sidianneng/batteryless_remote/doc/no_battery_ir_ctl-schematic-v04.pdf

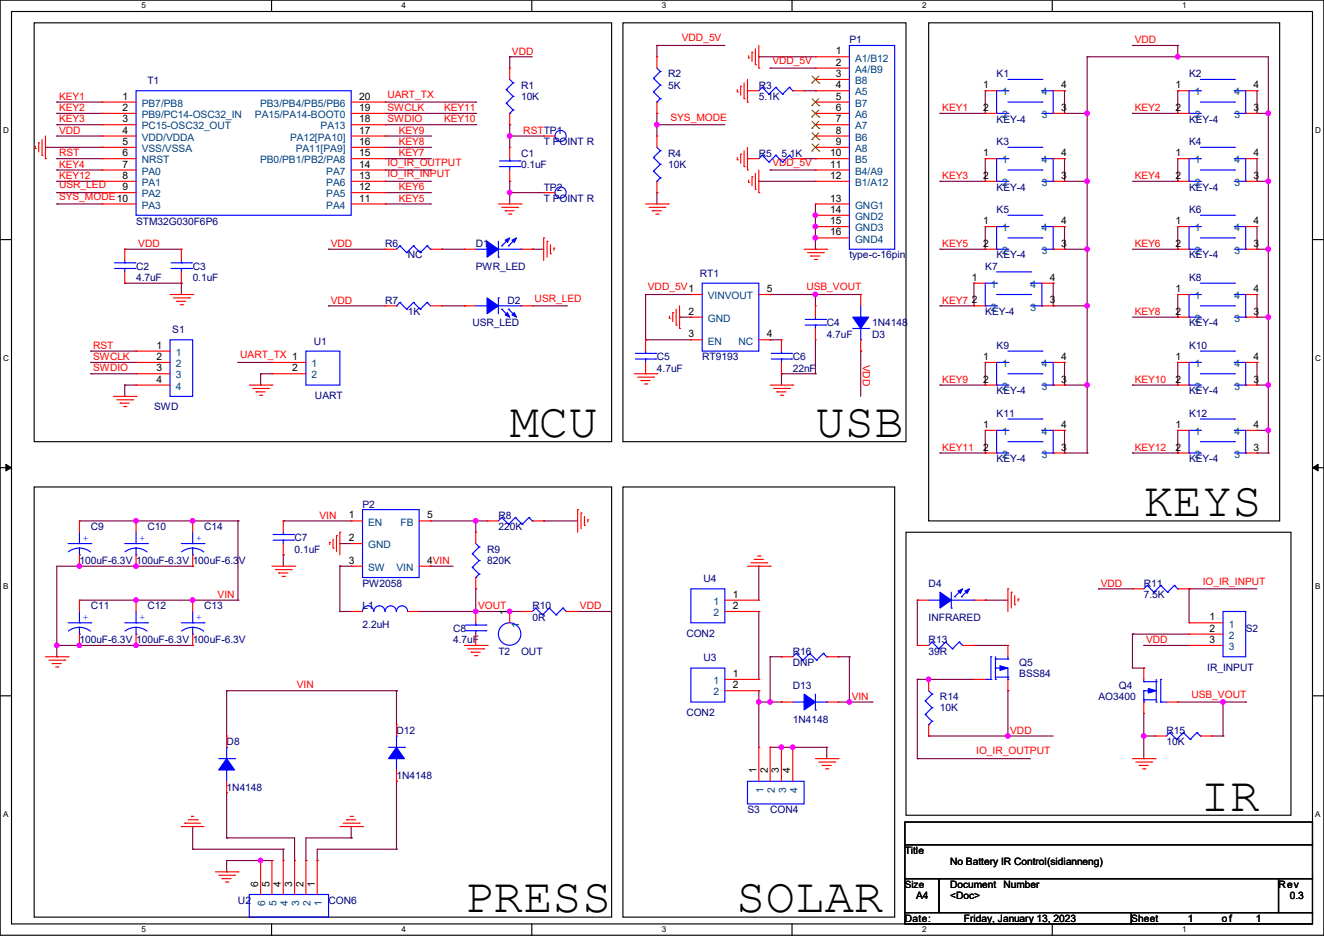
[picture p2: page 1]

No Battery IR Control(sidianneng)
