sidianneng/batteryless_remote/doc/no_battery_ir_ctl-pcb-v04.pdf

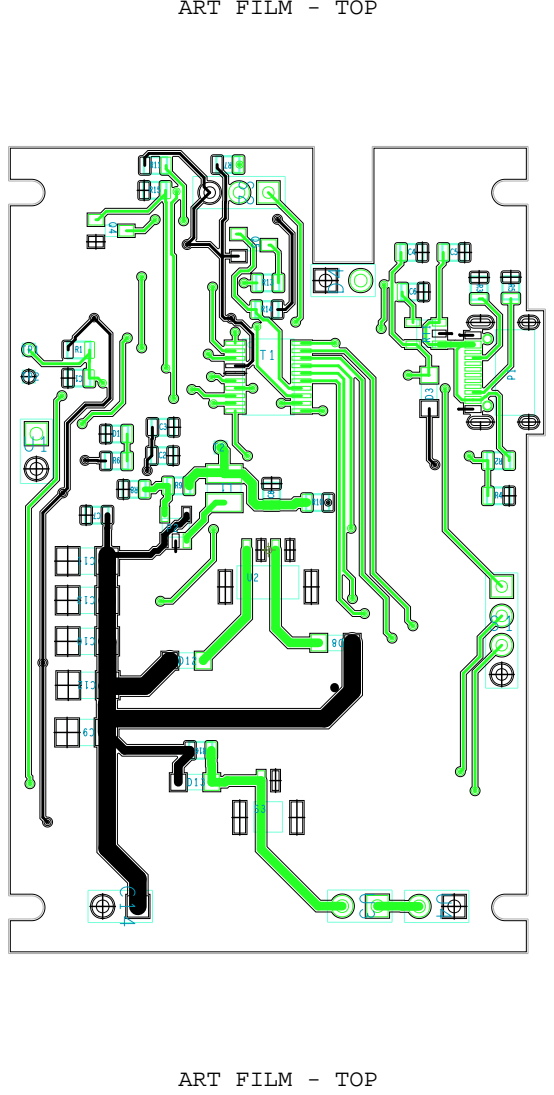
[picture p3: page 1]

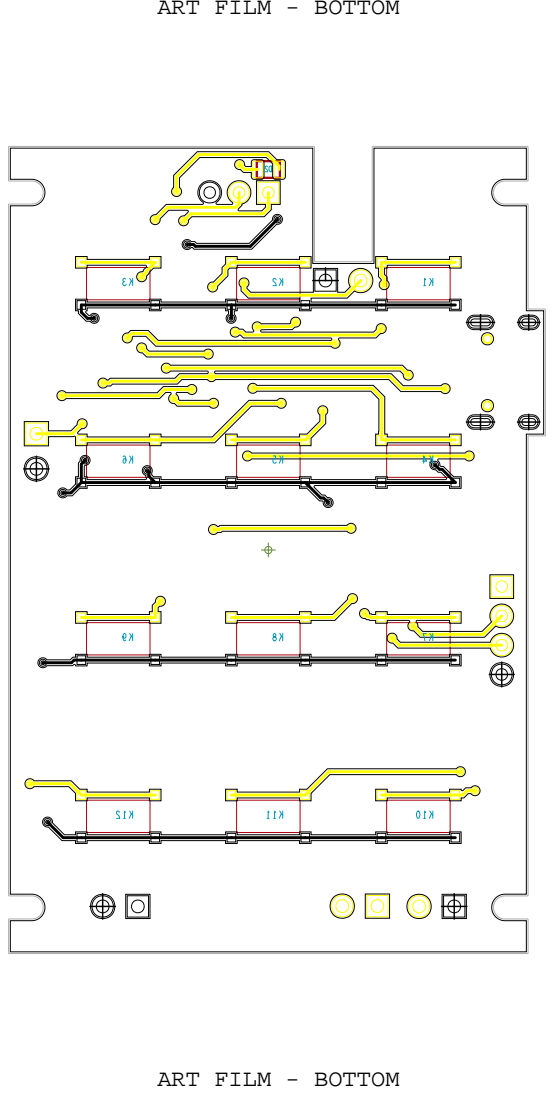
[picture p4: page 2]

ART FILM - BOTTOM

ART FILM - SILKSCREEN_BOTTOM

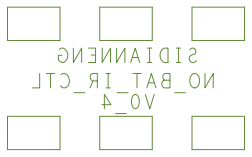
[picture p5: figure]

ART FILM - SILKSCREEN_BOTTOM

+

ART FILM - SILKSCREEN_TOP

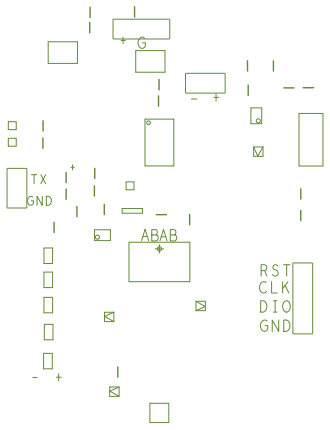
[picture p6: figure]
CLK; RST; GND; DIO; BAB

ART FILM - SILKSCREEN_TOP

+ -

+ -

+
