sidianneng/batteryless_remote/source_code/batteryless_remote/Core/Src/main.c

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
/* Includes ------------------------------------------------------------------*/
#include "main.h"
#include "usart.h"
#include "gpio.h"
#include "log.h"
#include "hxd019.h"
#include "flash.h"
#include "tim.h"
#include "ir_decode.h"


void SystemClock_Config(void);
/* USER CODE BEGIN PFP */
void EnterSleepMode(void);
void Enable_GPIO_Irq(void);
void Disable_GPIO_Irq(void);
/* USER CODE END PFP */

/**
 * @brief  The application entry point.
 * @retval int
 */
int main(void)
{
  /* USER CODE BEGIN 1 */
  uint8_t button_id = 0xff;
  /* USER CODE END 1 */

  /* MCU Configuration--------------------------------------------------------*/

  /* Reset of all peripherals, Initializes the Flash interface and the Systick. */

  LL_APB2_GRP1_EnableClock(LL_APB2_GRP1_PERIPH_SYSCFG);
  LL_APB1_GRP1_EnableClock(LL_APB1_GRP1_PERIPH_PWR);

  /* System interrupt init*/

  /* Configure the system clock */
  SystemClock_Config();

  /* Initialize all configured peripherals */
  MX_GPIO_Init();
  Log_Init();
  Log_Printf("batteryless remote start\n");
  Log_Printf("version: %d.%d\n", MAIN_VERSION, SUB_VERSION);
  MX_TIM3_Init();
  MX_TIM14_Init();
  MX_TIM16_Init();

into_sleep:
  Log_Printf("System Enter sleep\n");
  Enable_GPIO_Irq();
  EnterSleepMode();
  Log_Printf("wake up from sleep\n");
  Disable_GPIO_Irq();

  /* USER CODE BEGIN 2 */
  if (Get_Run_Mode() == IR_OUTPUT_MODE)
  {
    Log_Printf("IR OUTPUT MODE\n");
    button_id = Ir_Get_Button();
    if (button_id != 0xff)
    {
      Log_Printf("button id:%d\n", button_id);
      Log_Printf("output ret:%d\n", Ir_Output(button_id));
    }
    goto into_sleep;
  }
  else
  {
    Log_Printf("IR LEARN MODE\n");
    while (1)
    {
      if (Get_Run_Mode() != IR_LEARN_MODE)
      {
        Log_Printf("IR LEARN exit\n");
        goto into_sleep;
      }
      button_id = Ir_Get_Button();
      if (button_id != 0xff)
      {
        Log_Printf("button id:%d\n", button_id);
        ir_decode_init();
        LL_TIM_CC_EnableChannel(TIM3, LL_TIM_CHANNEL_CH1);
        LL_TIM_EnableIT_CC1(TIM3);
        LL_TIM_EnableCounter(TIM3);
        Log_Printf("learn ret:%d\n", Ir_Learn(button_id, 10));
      }
    }
  }
  /* USER CODE END 2 */

  /* Infinite loop */
  /* USER CODE BEGIN WHILE */
  while (1)
  {
    /* USER CODE END WHILE */

    /* USER CODE BEGIN 3 */
  }
  /* USER CODE END 3 */
}

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
/* USER CODE BEGIN 4 */
void EnterSleepMode(void)
{
  /** Request to enter "Stop 0" mode
   * Following procedure describe in STM32G0xx Reference Manual
   * See PWR part, section Low-power modes, "Stop 0" mode
   */
  /* Set Stop 0 mode when CPU enters deepsleep */
  LL_PWR_SetPowerMode(LL_PWR_MODE_STOP1);

  /* Set SLEEPDEEP bit of Cortex System Control Register */
  LL_LPM_EnableDeepSleep();

  /* Request Wait For Interrupt */
  __WFI();
}

void Enable_GPIO_Irq(void)
{
  NVIC_EnableIRQ(EXTI0_1_IRQn);
  NVIC_EnableIRQ(EXTI2_3_IRQn);
  NVIC_EnableIRQ(EXTI4_15_IRQn);
}

void Disable_GPIO_Irq(void)
{
  NVIC_DisableIRQ(EXTI0_1_IRQn);
  NVIC_DisableIRQ(EXTI2_3_IRQn);
  NVIC_DisableIRQ(EXTI4_15_IRQn);
}
/* USER CODE END 4 */
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
