sidianneng/batteryless_remote/source_code/batteryless_remote/Core/Src/hxd019.c

/*******************************************************************************
--万能遥控器IC hxd019驱动程序
--zrpeng
--2015-10-10
--
--note:
hxd019c和hxd019d的有区别

--history:

*******************************************************************************/

#include "hxd019.h"


/******************************************************************************
 * i2c
 */
void 
i2c_init(void)
{
	SDA_H;
	SCL_H;
}

void 
i2c_start(void)
{
	SDA_H;
	SCL_H;
	NOP5us;
	SDA_L;
	NOP5us;
	SCL_L;
}

void 
i2c_stop(void)
{
	SCL_L;
	SDA_L;
	NOP5us;
	SCL_H;
	NOP5us;
	SDA_H;
	NOP5us;
}
/*
 * 等待从机应答信号
 * return：1，接收应答失败
 *         0，接收应答成功
 */
uint8_t 
i2c_waitack(void)
{
	uint8_t err_cnt = 0;
	SDA_IN();
	SCL_H;
	NOP5us;
	while (SDA_is_H)
	{
		err_cnt++;
		if (err_cnt > 250)
		{
			i2c_stop();
			return 1;
		}
	}
	SCL_L;
	SDA_OUT();
	NOP5us;
	return 0;
}
void 
i2c_ack(void)
{
	SCL_L;
	SDA_L;
	NOP5us;
	SCL_H;
	NOP5us;
	SCL_L;
}
void 
i2c_nack(void)
{
	SCL_L;
	SDA_H;
	NOP5us;
	SCL_H;
	NOP5us;
	SCL_L;
}
/*
 * 发送一个字节
 */
void 
i2c_sendbyte(uint8_t txd)
{
	uint8_t t;
	SCL_L;
	for (t = 0; t < 8; t++)
	{
		if (txd & 0x80)
		{
			SDA_H;
		}
		else
		{
			SDA_L;
		}
		txd <<= 1;
		NOP5us;
		SCL_H;
		NOP5us;
		SCL_L;
	}
	NOP5us;
}

/*
 * 读1个字节并返回
 * @ack 1:发送ACK，0:发送nACK
 */
uint8_t 
i2c_readbyte(uint8_t ack)
{
	uint8_t i, receive = 0;
	SDA_IN();
	SCL_L;
	NOP5us;
	for (i = 0; i < 8; i++ )
	{
		SCL_H;
		NOP5us;
		receive <<= 1;
		if (SDA_is_H)
		{
			receive |= 0X01;
		}
		SCL_L;
		NOP5us;
	}
	SDA_OUT();
	if (!ack)
	{
		i2c_nack();
	}
	else
	{
		i2c_ack();
	}
	return receive;
}




/******************************************************************************
 * hxd019
 */
static uint8_t hxd_learn_data[232];		// 存储原始的学习数据

// 学习成功，可以直接发送这个编码
static uint16_t learn_timeout_cnt;
static uint8_t learn_method = 1;			// 默认是学习方法1, 学习方法2匹配结果更准确一些

/*
 * hxd019特有的开头时序，每一次i2c_start前必须要调用
 */
static void 
hxd_i2c_init(void)
{
	SDA_H;
	SCL_H;
	NOP5us;
	SCL_L;
	NOP5us;				// 发送一个低脉冲
	SCL_H;
	os_delay_us(20000);	// 然后空闲20ms
}

void 
hxd019_init(void)
{
	i2c_init();

	//PIN_FUNC_SELECT(BUSY_PIN_MUX, BUSY_PIN_FUNC);
	//gpio_output_set(0, 0, 0, 1 << BUSY_PIN);
}

/*
 * 写入一组编码数据，触发hxd019发射对应编码的红外信号.
 *
 * @*buf  编码数据，格式如下:{F_code(1 byte)+KEY_code(2 byte)+COM_CODE(4 byte)+CHECKSUM}
 *        F_code,KEY_code,COM_CODE在码库文件中查询.
 * @n     buf的长度
 *
 * note   学习1处理后的数据: 0x30 0x00 + 110字节数据
 *        学习2处理后的数据: 0x30 0x03 + 230字节数据
 */
void 
hxd019_write(uint8_t *buf, int n)
{
	int i;

	hxd_i2c_init();
	i2c_start();
	for (i = 0; i < n; i++)
	{
		i2c_sendbyte(buf[i]);
		i2c_waitack();
	}
	i2c_stop();
}

/*
 * 读取hxd019学习到的编码数据
 * @*buf  存储学习到的编码数据
 *
 * @return  0:读取成功  1:读取失败
 */
uint8_t 
hxd019_read(uint8_t *buf)
{
	uint8_t value;
	uint8_t checksum;
	int i;
	uint8_t b1, b2, b3;
	int num;

	if (learn_method == 1)
	{
		b1 = 0x30;
		b2 = 0x52;
		b3 = 0x31;
		num = 110;
	}
	else if (learn_method == 2)
	{
		b1 = 0x30;
		b2 = 0x62;
		b3 = 0x31;
		num = 230;
	}
	hxd_i2c_init();
	i2c_start();
	i2c_sendbyte(b1);			// 器件地址，写
	i2c_waitack();
	i2c_sendbyte(b2);			// 学习数据的存储地址
	i2c_waitack();
	i2c_start();				// 切换方向，重新启动i2c信号
	i2c_sendbyte(b3);			// 器件地址，读
	i2c_waitack();
	value = i2c_readbyte(1);	// 读取1字节FCS(校验和)

	if (value != 0)				// 如果没有学习数据，value不为0
	{
		i2c_stop();
		return 1;
	}

	buf[0] = value;

	checksum = b1 + b2 + b3;	// 已发送字节b1 b2 b3校验和

	for (i = 1; i < num; i++)	// 读出hxd019学习到的编码数据
	{
		buf[i] = i2c_readbyte(1);
		checksum += buf[i];
	}

	value = i2c_readbyte(0);	// 读取FCS(校验和)
	i2c_stop();

	if (learn_method == 1)
	{
		if (value != checksum)
		{
			HXD019_PRINTF("hxd019_read: checksum error\n");
			return 1;
		}
		else
		{
			HXD019_PRINTF("hxd019_read: checksum ok\n");
			return 0;
		}
	}
	else if (learn_method == 2)
	{
		HXD019_PRINTF("hxd019_read: checksum ok\n");
		return 0;
	}

	return 0;
}

/*
 * 配置hxd019进入学习状态,并等待学习数据,学习成功后的学习数据存储在hxd019_learn_data[]中
 *
 * @method  1:学习1(110字节学习数据)  2:学习2(230字节学习数据)
 * @func    学习结果回调
 *
 * @return  0:学习成功 1:学习超时(20s超时后,busy脚自动变高)
 *
 * notes   1)红外编码信号LSb在前
 *         2)要靠近红外收发头5cm内才能学习到数据
 */
void 
hxd019_learn(uint8_t method, uint8_t *output_data, uint8_t size)
{
	int n = 0;
	uint8_t b1, b2, b3;
	uint32_t time_cnt = 0;
	uint8_t checksum = 0;

	if(!output_data || !size)
		return ;

	if (method != 1 && method != 2)
	{
		return;
	}

	learn_method = method;
	hxd_i2c_init();
	i2c_start();
	if (method == 1)
	{
		b1 = 0x30;
		b2 = 0x10;
		b3 = 0x40;
	}
	else if (method == 2)
	{
		b1 = 0x30;
		b2 = 0x20;
		b3 = 0x50;
	}
	i2c_sendbyte(b1);		// 器件地址，写
	i2c_waitack();
	i2c_sendbyte(b2);		// 要写的寄存器地址
	i2c_waitack();
	i2c_sendbyte(b3);		// 写入寄存器的值
	i2c_waitack();
	i2c_stop();

	os_delay_us(10000);

	while(1)
	{
		if (HXD019_BUSY_is_H)
		{
			HXD019_PRINTF("hxd019 learn OK\n");
			if (hxd019_read(hxd_learn_data+2))
			{
				HXD019_PRINTF("hxd019_read() failed\n");
			}
			else
			{
				break;
			}
		}
		os_delay_us(10000);
		time_cnt++;
		if(time_cnt >= 2000)
		{
			HXD019_PRINTF("hxd019 learn failed\n");
			break;
		}
	}

	hxd_learn_data[0] = 0x30;
	hxd_learn_data[1] = 0x03;
	checksum += hxd_learn_data[0];
	checksum += hxd_learn_data[1];
	for(uint8_t i  = 3;i < sizeof(hxd_learn_data) - 1; ++i)
	{
		hxd_learn_data[i - 1] = hxd_learn_data[i];
		checksum += hxd_learn_data[i - 1];
	}
	hxd_learn_data[sizeof(hxd_learn_data) - 1] = checksum;
	memcpy(output_data, hxd_learn_data, size);

}



#ifdef HXD019_TEST
/******************************************************************************
 *  hxd019测试
 */
/*
 * 发码格式: 0x30+0x00+F_code(1B)+KEY_code(2B)+COM_CODE(4B)+CHECKSUM
 */
uint8_t test_tbl[][7] =
{
	// 投影仪的几组测试编码
	//fmt     key         custom_code
	{0x01, 0x90, 0x6f, 0x83, 0x55, 0x00, 0x00}, /*0*/
	{0x01, 0x12, 0xed, 0xE7, 0x0A, 0x00, 0x00}, /*1*/
	{0x0B, 0xaf, 0x50, 0x0d, 0x00, 0x22, 0x88}, /*2*/

	// 风扇的几组测试编码
	{0x63, 0x20, 0xdf, 0x03, 0x03, 0x00, 0x00}, /*0*/
	{0x63, 0x20, 0xdf, 0x03, 0x03, 0x00, 0x00}, /*1*/
	{0x01, 0x03, 0xfc, 0x01, 0xfe, 0x00, 0x00}, /*2*/

	// 机顶盒测试编码
	{0x01, 0x0B, 0xF4, 0x44, 0x9B, 0x00, 0x00}, /*0*/
	{0x21, 0x26, 0x0c, 0x80, 0x10, 0x00, 0x00}, /*1*/
	{0x01, 0x43, 0xBC, 0x08, 0xE6, 0x00, 0x00}, /*2*/

	// DVD测试编码
	{0x01, 0x51, 0xAE, 0x00, 0xFF, 0x20, 0x88}, /*0*/
	{0x01, 0x5E, 0xA1, 0x00, 0x99, 0x20, 0x88}, /*1*/
	{0x01, 0x55, 0xAA, 0x01, 0xFE, 0x20, 0x88}, /*2*/

	// 电视测试编码
	{0x04, 0x11, 0xEE, 0xC0, 0x00, 0x20, 0x88}, /*0*/
	{0x09, 0x07, 0xF8, 0x04, 0x00, 0x20, 0x88}, /*1*/  /* 长虹的第二组代号：1 */
	{0x05, 0x1A, 0xE5, 0x08, 0x08, 0x20, 0x88}, /*2*/

	// 网络机顶盒(IPTV)测试编码
	{0x01, 0x43, 0xbc, 0x11, 0xee, 0x00, 0x00}, /*0*/
	{0x01, 0x9c, 0x63, 0x11, 0xee, 0x00, 0x00}, /*1*/
	{0x01, 0x0f, 0xf0, 0x01, 0xfe, 0x00, 0x00}, /*2*/

};

/*
 * 空调发码测试, 测试ok, 全部都可以发出红外信号
 * 0x30+0x01+(2B)+(7B)+(1B)+(?B：arc_table)+0xFF+(1B)
 */
uint8_t test_arc_tbl[][76] =
{
	/*  0 ~ 9 */
	{0x04, 0x00, 0x0F, 0x04, 0x3D},  /* 511以后：(0x02,0x00,0x00),511-0,512-1.。。。678=167 */
	{0x04, 0x00, 0x0F, 0x04, 0x3C},
	{0x04, 0x00, 0x0F, 0x04, 0x10},
	{0x04, 0x00, 0x0F, 0x04, 0x13},
	{0x04, 0x00, 0x0F, 0x04, 0x1B},
	{0x04, 0x00, 0x0F, 0x04, 0x34},
	{0x04, 0x00, 0x0F, 0x04, 0x1D},
	{0x04, 0x00, 0x0F, 0x04, 0x5E},
	{0x04, 0x00, 0x87, 0x04, 0x2A},
	{0x04, 0x00, 0x0F, 0x04, 0x15},
	/*  10 ~ 19 */
	{0x04, 0x00, 0x87, 0x04, 0x13},
	{0x04, 0x00, 0x0F, 0x04, 0x34},
	{0x06, 0x00, 0x87, 0x04, 0xFF, 0x06, 0x1C},
	{0x06, 0x00, 0x8E, 0x04, 0xFF, 0x06, 0x1C},
	{0x06, 0x00, 0x8F, 0x04, 0xFB, 0x06, 0x1D},
	{0x06, 0x00, 0x8F, 0x04, 0xFE, 0x06, 0x1D},
	{0x06, 0x00, 0x87, 0x04, 0xFF, 0x06, 0x1D},
	{0x06, 0x00, 0x8E, 0x04, 0xFF, 0x06, 0x1D},
	{0x04, 0x00, 0x0F, 0x04, 0x1D},
	{0x06, 0x00, 0x0F, 0x04, 0x15, 0x06, 0xA5},
	/*  20 ~ 29 */
	{0x0c, 0x00, 0x23, 0x01, 0xCB, 0x02, 0x26, 0x03, 0x01, 0x05, 0x20, 0x07, 0x80},
	{0x0a, 0x00, 0x23, 0x01, 0xCB, 0x02, 0x26, 0x03, 0x01, 0x05, 0x20},
	{0x0c, 0x00, 0x11, 0x01, 0x11, 0x02, 0x11, 0x03, 0x11, 0x04, 0x11, 0x05, 0x20},
	{0x0a, 0x00, 0x11, 0x01, 0x11, 0x02, 0x11, 0x03, 0x11, 0x04, 0x11},
	{0x0a, 0x00, 0x23, 0x01, 0xCB, 0x02, 0x26, 0x03, 0x01, 0x05, 0x23},
	{0x0e, 0x00, 0x11, 0x01, 0x11, 0x02, 0x11, 0x03, 0x11, 0x04, 0x11, 0x05, 0x20, 0x08, 0x10},
	{0x0e, 0x00, 0x11, 0x01, 0x11, 0x02, 0x11, 0x03, 0x11, 0x04, 0x11, 0x05, 0x20, 0x08, 0x10},
	{
		0x2f, 0x8D, 0x71, 0x00, 0x4D, 0x01, 0xB2, 0x02, 0xf0, 0x03, 0x0F, 0x04, 0x07,
		0x05, 0xf8, 0x8D, 0x72, 0x00, 0x4D, 0x01, 0xB2, 0x02, 0xD6, 0x03, 0x29,
		0x04, 0x07, 0x05, 0xf8, 0x06, 0x4D, 0x07, 0xB2, 0x08, 0xD6, 0x09, 0x29,
		0x0A, 0x07, 0x0B, 0xf8, 0x8D, 0x73, 0x00, 0x4D, 0x02, 0xD8, 0x8D
	},
	{
		0x19, 0x8D, 0x6F, 0x00, 0x4D, 0x01, 0xB2, 0x02, 0xD6, 0x03, 0x29, 0x04, 0x07,
		0x05, 0xF8, 0x8D, 0x73, 0x00, 0x4D, 0x02, 0xD8, 0x06, 0x4D, 0x08, 0xD8,
		0x8D
	},
	{0x08, 0x00, 0x80, 0x03, 0x23, 0x05, 0x90, 0x06, 0x12},
	/*  30 ~ 39 */
	{
		0x21, 0x8D, 0x76, 0x00, 0x3f, 0x01, 0xc0, 0x02, 0x0F, 0x8D, 0x77, 0x00, 0x3f,
		0x01, 0xc0, 0x8D, 0x6F, 0x00, 0x3F, 0x8D, 0x74, 0x00, 0x3F, 0x8D, 0x6D,
		0x00, 0x3f, 0x01, 0xc0, 0x02, 0x0F, 0x04, 0x0F, 0x8D
	},
	{0x0c, 0x00, 0x4D, 0x01, 0x75, 0x02, 0xB2, 0x03, 0x8A, 0x04, 0x0F, 0x12, 0x10},
	{0x0c, 0x00, 0x4D, 0x01, 0x75, 0x02, 0xB2, 0x03, 0x8A, 0x04, 0x0F, 0x0C, 0x10},
	{0x02, 0x2, 0x55},
	{0x04, 0x00, 0x15, 0x04, 0x10},
	{
		0x1f, 0x8D, 0x71, 0x00, 0xD1, 0x01, 0x2E, 0x02, 0xD1, 0x03, 0x2E, 0x8D, 0x72,
		0x00, 0xD0, 0x01, 0x2F, 0x02, 0xD0, 0x03, 0x2F, 0x8D, 0x73, 0x00, 0xC0,
		0x02, 0x10, 0x04, 0xC0, 0x06, 0x10, 0x8D
	},
	{
		0x13, 0x8D, 0x71, 0x00, 0xD1, 0x01, 0x2E, 0x8D, 0x72, 0x00, 0xD0, 0x01, 0x2F,
		0x8D, 0x73, 0x00, 0x0C, 0x02, 0x10, 0x8D
	},
	{
		0x0f, 0x8D, 0x6F, 0x00, 0x15, 0x01, 0xEA, 0x8D, 0x73, 0x00, 0x15, 0x01, 0xEA,
		0x06, 0x0C, 0x8D
	},
	{0x04, 0x00, 0x15, 0x01, 0xC0},
	{0x04, 0x07, 0x03, 0x09, 0xCC},
};

void 
hxd019_print_learn(void)
{
	int num;
	int i;
	HXD019_PRINTF("hxd_learn_data:\n");
	if (learn_method == 1)
	{
		num = 110;
	}
	else if (learn_method == 2)
	{
		num = 230;
	}

	for (i = 0; i < num; i++)
	{
		HXD019_PRINTF("0x%x ", hxd_learn_data[i]);
	}
	HXD019_PRINTF("\n");
}

/*
 * 非空调设备发码测试
 * @n  发第几组测试编码
 */
void 
hxd019_noarc_write_test(int n)
{
	uint8_t checksum;
	uint8_t tbl[20];
	uint8_t i;

	tbl[0] = 0x30;
	tbl[1] = 0;
	for (i = 0; i < 7; i++)
	{
		tbl[i + 2] = test_tbl[n][i];
	}

	checksum = 0;
	for (i = 0; i < 9; i++)
	{
		checksum += tbl[i];
	}
	tbl[i] = checksum;

	hxd019_write(tbl, 10);
}

/*
 * 空调设备发码测试
 */
void 
hxd019_arc_write_test(int n)
{
	uint8_t checksum;
	uint8_t tbl[100];
	uint8_t i, j;
	static uint8_t sw=0;

	// 2bytes
	tbl[0] = 0x30;
	tbl[1] = 0x01;

	// 2bytes arc_table[]组号高低字节
	tbl[2] = (n >> 8) & 0xff;
	tbl[3] = n & 0xFF;

	//空调数据(7bytes):温度，模式，风向，电源...
	tbl[4] = 25;	// 空调温度
	tbl[5] = 4;		// 风力
	tbl[6] = 2;		// 手动
	tbl[7] = 1;		// 自动
	tbl[8] = !sw;// 开关
	tbl[9] = 1;		// 键名对应数据和显示
	tbl[10] = 1;	// 模式对应数据和显示

	//填充arc_table中的一组数据
	tbl[11] = test_arc_tbl[n][0] + 1;
	memmove(&tbl[12], &test_arc_tbl[n][1], tbl[11] - 1);

	i = 11 + tbl[11];	// 偏移到arc_table填充数据的后一个字节
	tbl[i] = 0xFF;		// 固定0xFF
	i++;

	//校验和
	checksum = 0;
	for (j = 0; j < i; j++)
	{
		checksum += tbl[j];
	}
	tbl[i] = checksum;
	i++;

	hxd019_write(tbl, i);
}

void 
learn_test_func(uint8_t *data, int length, uint8_t status)
{
	if (status == HXD019_OK)
	{
		HXD019_PRINTF("learn_test_func: learn ok\n");
		hxd019_print_learn();
	}
	else if (status == HXD019_TIMEOUT)
	{
		HXD019_PRINTF("learn_test_func: learn timeout\n");
	}
}

void 
hxd019_learn_write_test(uint8_t *buf, int n)
{
	int i;

	hxd_i2c_init();

	i2c_start();
	i2c_sendbyte(0x30);		// 器件地址，写
	i2c_waitack();
	i2c_sendbyte(0x00);		// 要写的寄存器地址
	i2c_waitack();

	for (i = 0; i < n; i++)
	{
		i2c_sendbyte(buf[i]);
		i2c_waitack();
	}
	i2c_stop();
}
#endif
