sidianneng/batteryless_remote/source_code/batteryless_remote/Core/Inc/error_code.h

/*
 * @Author: bbear2 bbear_mail@163.com
 * @Date: 2022-07-02 14:53:49
 * @LastEditors: bbear2 bbear_mail@163.com
 * @LastEditTime: 2022-07-02 14:58:20
 * @FilePath: \batteryless_remote\Core\Inc\error_code.h
 * @Description: error code definition
 */
#ifndef ERROR_CODE_H
#define ERROR_CODE_H

#ifdef __cplusplus
extern "C" {
#endif

#define IR_OK 0
#define IR_ERROR 1
#define IR_TIMEOUT 2
#define IR_INVAL 3
#define IR_FLASH_W_ERR 4

#ifdef __cplusplus
}
#endif

#endif
