sidianneng/batteryless_remote/source_code/batteryless_remote/Core/Inc/flash.h

/*
 * @Author: bbear2 bbear_mail@163.com
 * @Date: 2022-07-02 14:44:05
 * @LastEditors: bbear2 bbear_mail@163.com
 * @LastEditTime: 2022-07-13 01:01:27
 * @FilePath: \batteryless_remote\Core\Inc\flash.h
 * @Description: internal flash read/write
 */
#ifndef FLASH_H
#define FLASH_H

#ifdef __cplusplus
extern "C" {
#endif

#include "error_code.h"
#include "stdint.h"
#include "stm32g030xx.h"

/* flash config */
#define FLASH_PAGE_SIZE 2048
#define IRDATA_START_ADDR 0x08006800
#define IRDATA_END_ADDR   0x08007fff

#define FLASH_PEKEY1 0x45670123
#define FLASH_PEKEY2 0xcdef89ab

int16_t flash_read(uint32_t *addr, uint8_t *buf, uint16_t size);
int16_t flash_write(uint32_t *addr, uint8_t *buf, uint16_t size, uint32_t timeout);

#ifdef __cplusplus
}
#endif

#endif
