sidianneng/batteryless_remote/(commit log)

2022-06-09 printf ok You can disable the printf by change the macro DEBUG_LOG to 0 in config.h ATTENTION: Because the SWCLK and uart tx share the same pin(PA14). So after we enable the printf.Every time we flas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
    [config.h, log.c, log.h, main.c]
2022-06-12 Log_printf ok It can be used just like the printf. You can disable the printf by change the macro DEBUG_LOG to 0 in config.h ATTENTION: Because the SWCLK and uart tx share the same pin(PA14). So afte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
    [config.h, log.c, log.h, main.c]
2022-06-22 timer input capture interrrupt ok
2022-06-28 timer input capture OK
2022-07-06 init commit for hxd019 driver
2022-07-06 hxd019 driver can work now
2022-07-07 hxd019 driver is OK
2022-07-09 hxd019 driver learn/send code works fine now
2022-07-11 Change the MCU from stm32l011f4 to stm32g030f6 Why do this change? Because we need more space to store the IR data. we need 230 bytes for every IR command. On stm32l011f4, there is only 512bytes eepr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
2022-07-12 add the code of flash operation and error code
    [eeprom.c, eeprom.h, error_code.h]
2022-07-13 fix the uart
2022-07-13 fix the hxd019 driver
    [hxd019.c]
2022-07-14 flash write/read is OK on stm32g030f6p6
2022-07-16 increase printf buff to 64 Bytes
2022-08-03 stm32g030 input capture OK
2022-08-11 new board works fine with hxd019
2022-08-14 change the user led gpio to PA2
2022-08-21 add the led action to notify the user IR learn is finish
2022-08-21 fix the ir_decode init
    [ir_decode.c]
2022-08-21 Optimize the interrupt code of IR learning This commit make it can do the IR learn action for more than one time without reset the board.
    [ir_app.c, main.c]
2022-08-22 add the code to detect the timer overflow IR sequence
2022-09-08 update jflash for stm32g030
2022-11-13 optimize the power consumption of IR output control at startup
2022-11-13 optimize the IR outpu mode code for better power consumption
2022-11-13 add low power mode for IR output
2022-11-16 fix the flash write
    [flash.c]
2022-11-24 optimize the power consumption of pwm idle time
2022-11-25 add the code the dynamic calculate the time we need to prees the button
2022-12-03 match the new PCB board
2022-12-10 upload the schematic bom PCB & gerber files
2022-12-10 add the stl file for 3D modules
2023-01-02 match the new board with solar energy battery
2023-01-12 update the BOM for new board with solar power
2023-01-12 update the new schematic of solar power
2023-01-12 update the PCB file of solar power
2023-01-12 update the new gerber file
